giacomo-zanichelli/esp32_dev_board/esp32_dev_board.kicad_pcb

## KiCad design esp32_dev_board.kicad_pcb (2021-04-11)

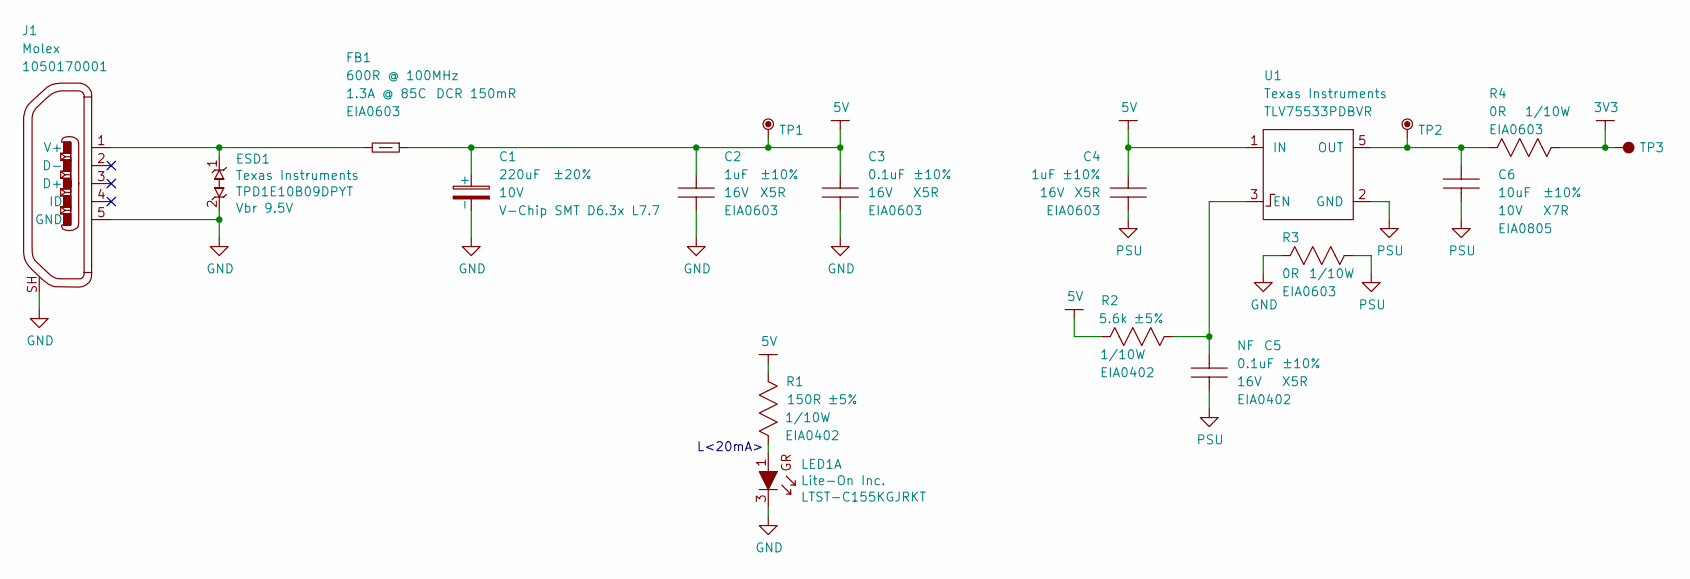
[picture p1: schematic psu.sch]

Parts:
C1: WE-865080245009; WE-86508xx450xx_CAPAE660X770D730L255X65N; Tolerance ±20%; Voltage 10V; MPN 865080245009
C2, C4: CAP-EIA0603; CAPC160X80X95L35N; Tolerance ±10%; Voltage 16V; MPN C0603C105K4PACTU
C3: CAP-EIA0603; CAPC160X80X95L35N; Tolerance ±10%; Voltage 16V; MPN C0603C104K4PACTU
C5: CAP-EIA0402; CAPC100X50X55L30N; Tolerance ±10%; Voltage 16V; MPN C0402C104K4PACTU
C6: CAP-EIA0805; CAPC200X125X110L50N; Tolerance ±10%; Voltage 10V; MPN C0805C106K8RACTU
ESD1: TI-TPD1E10B09DPYT; TI-TPD1E10B09DPYT_DIODFN2_100X60X45L25X50N; Breakdown Voltage Vbr 9.5V; MPN TPD1E10B09DPYT
FB1: FB-EIA0603; BEADC160X80X95L40N; MPN BLM18KG601SN1D
J1: Molex-1050170001; MPN 1050170001
LED1: LiteOn-LTST-C155KGJRKT; LiteOn-LTST-C155_LEDCAV4P138_270X320X110L50X90N; MPN LTST-C155KGJRKT
R1: RES-EIA0402; RESC100X50X40L25NN; Tolerance ±5%; Voltage N/A; MPN ERJ2GEJ151X
R2: RES-EIA0402; RESC100X50X40L25NN; Tolerance ±5%; Voltage N/A; MPN ERJ2GEJ562X
R3, R4: RES-EIA0603; RESC160X85X55L30N; Tolerance N/A; Voltage N/A; MPN ERJ3GEY0R00V
TP1, TP2: Test-Point-THT; TestPoint-THT_C150H100
TP3: Test-Point-SMT; TestPoint-SMT_C100
U1: TI-TLV75533PDBVR; TI-TLV755_SOT23-5P95_280X145L45X40N; MPN TLV75533PDBVR

Connections:
3V3: R4.2, TP3.1; also elsewhere on the board
5V: C1.1 (+), C2.1, C3.1, C4.1, FB1.2, R1.2, R2.2, TP1.1, U1.1 (IN)
GND: C1.2 (-), C2.2, C3.2, ESD1.2, J1.5 (GND), J1.SH, LED1.3 (C), R3.1; also elsewhere on the board
unnamed: C5.1, R2.1, U1.3 (EN)
unnamed: C6.1, R4.1, TP2.1, U1.5 (OUT)
unnamed: ESD1.1, FB1.1, J1.1 (V+)
unnamed: LED1.1 (A), R1.1
PSU: C4.2, C5.2, C6.2, R3.2, U1.2 (GND)

Notes on the sheet:
L<20mA>

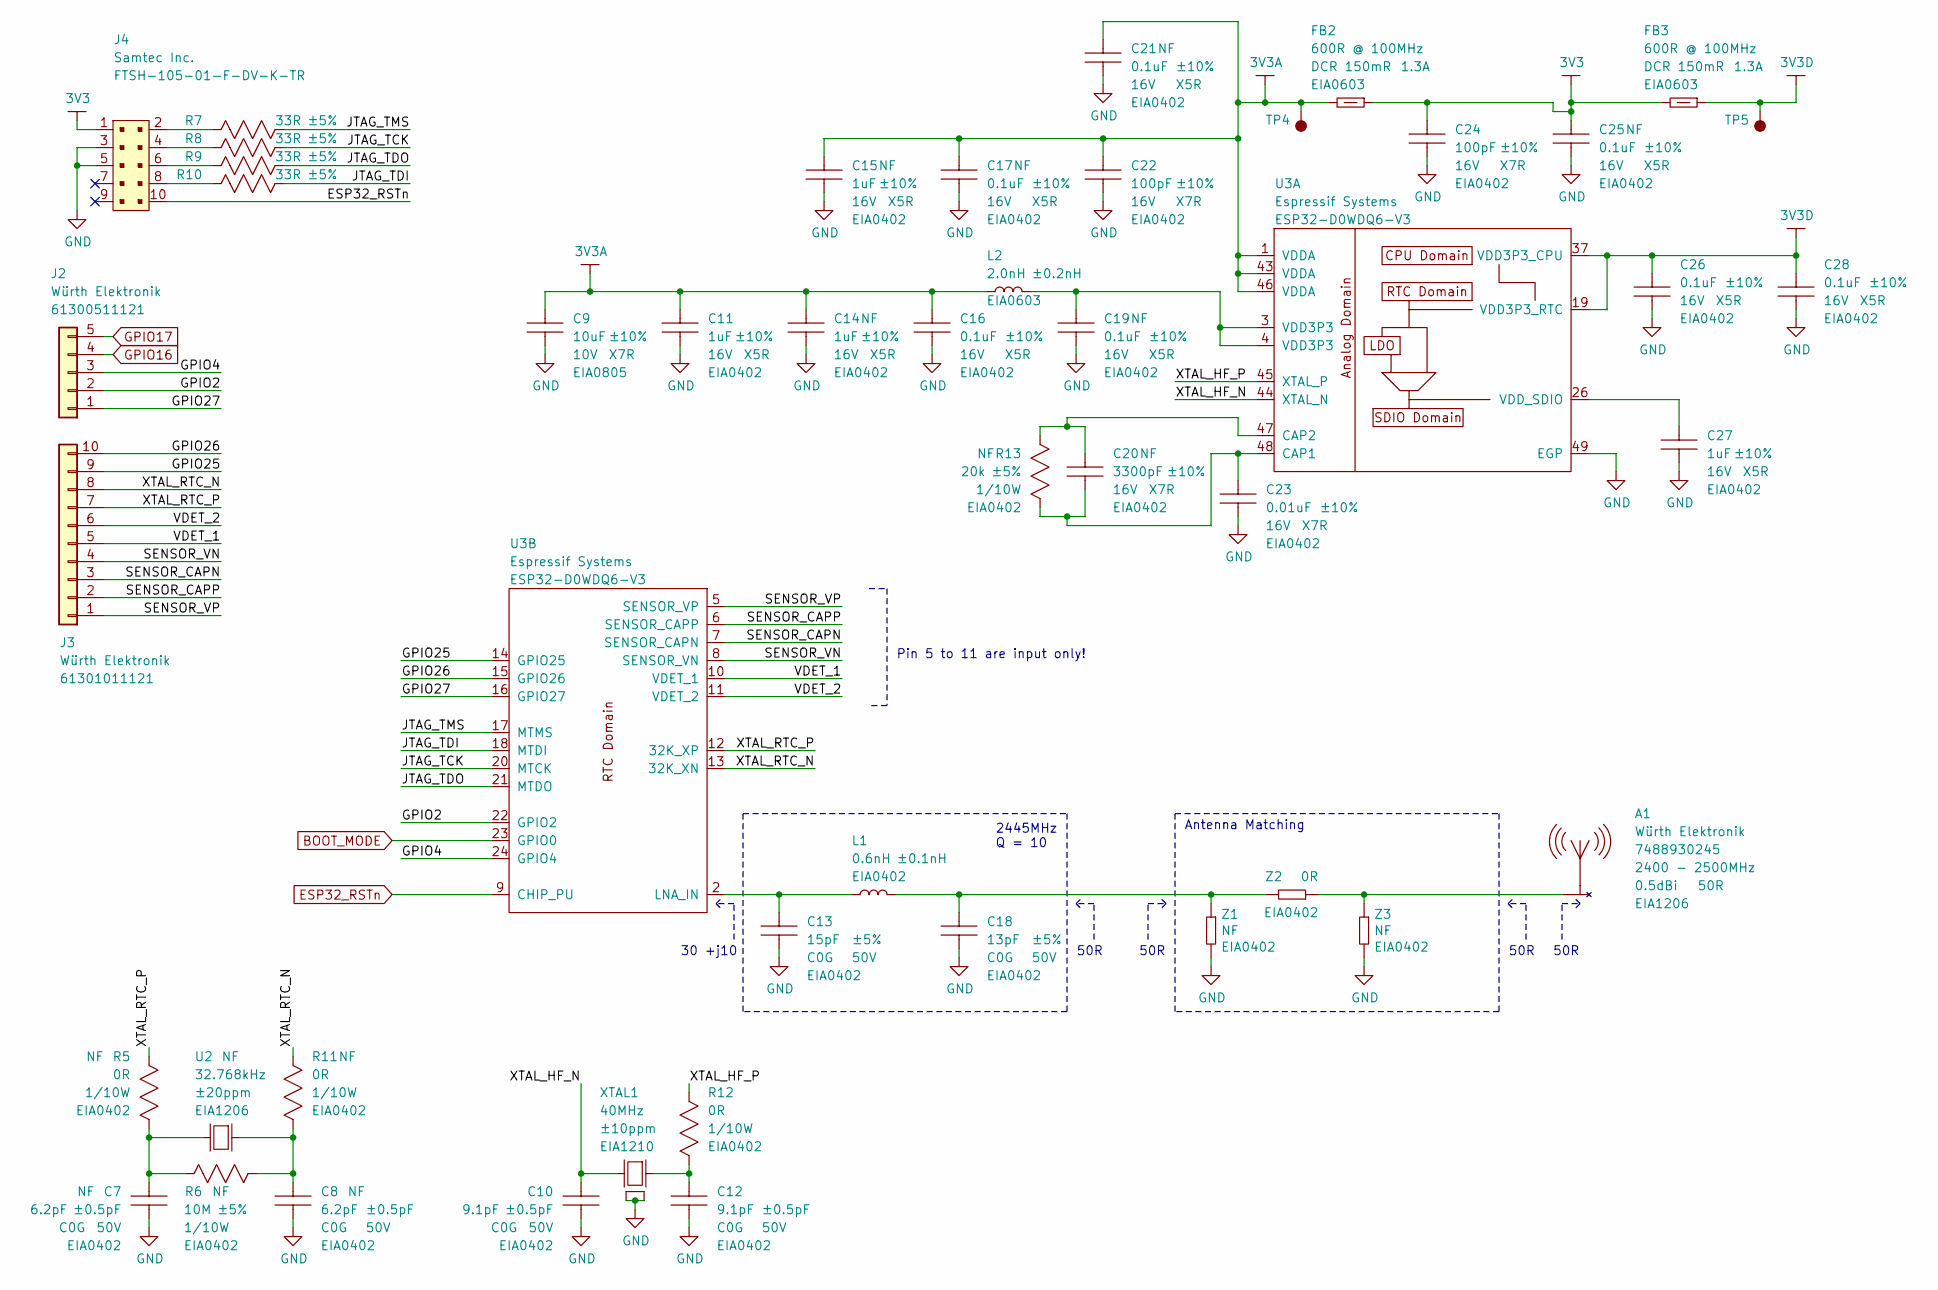
[picture p2: schematic mcu.sch]

Parts:
A1: WE-7488930245; WE-7488930245_ANTC320X160X140L50N; MPN 7488930245
C7, C8, C10, C12: CAP-EIA0402; CAPC100X50X55L30N; Tolerance ±0.5pF; Voltage 50V; MPN C0402C919D5GACTU
C9: CAP-EIA0805; CAPC200X125X110L50N; Tolerance ±10%; Voltage 10V; MPN C0805C106K8RACTU
C11, C14, C15, C27: CAP-EIA0402; CAPC100X50X55L30N; Tolerance ±10%; Voltage 16V; MPN C0402C105K4PACTU
C13: CAP-EIA0402; CAPC100X50X55L30N; Tolerance ±5%; Voltage 50V; MPN C0402C150J5GACTU
C16, C17, C19, C21, C25, C26, C28: CAP-EIA0402; CAPC100X50X55L30N; Tolerance ±10%; Voltage 16V; MPN C0402C104K4PACTU
C18: CAP-EIA0402; CAPC100X50X55L30N; Tolerance ±5%; Voltage 50V; MPN C0402C130J5GACTU
C20: CAP-EIA0402; CAPC100X50X55L30N; Tolerance ±10%; Voltage 16V; MPN C0402C332K4RACTU
C22, C24: CAP-EIA0402; CAPC100X50X55L30N; Tolerance ±10%; Voltage 16V; MPN C0402C101K4RACTU
C23: CAP-EIA0402; CAPC100X50X55L30N; Tolerance ±10%; Voltage 16V; MPN C0402C103K4RACTU
FB2, FB3: FB-EIA0603; BEADC160X80X95L40N; MPN BLM18KG601SN1#
J2: WE-61300511121; WE-61300511121_HDRV5W79P254_5X1_1270X254H854; MPN 61300511121
J3: WE-61301011121; WE-61301011121_HDRV10W64P254_10X1_2540X254X884N; MPN 61301011121
J4: Samtec-FTSH-105-01-F-DV-K-TR; Samtec_FTSH-105-01-F-DV-K-TR; MPN FTSH-105-01-F-DV-K-TR
L1: IND-EIA0402; INDC100X50X55L25N; Tolerance ±0.1nH; MPN MLG1005S0N6BT000
L2: IND-EIA0603; INDC160X80X95L40N; Tolerance ±0.2nH; MPN LQP03HQ2N0C02D
R5, R11, R12: RES-EIA0402; RESC100X50X40L25NN; Tolerance N/A; Voltage N/A; MPN ERJ2GE0R00X
R6: RES-EIA0402; RESC100X50X40L25NN; Tolerance ±5%; Voltage N/A; MPN ERJ2GEJ106X
R7, R8, R9, R10: RES-EIA0402; RESC100X50X40L25NN; Tolerance ±5%; Voltage N/A; MPN ERJ2GEJ330X
R13: RES-EIA0402; RESC100X50X40L25NN; Tolerance ±5%; Voltage N/A; MPN ERJ2GEJ203X
TP4, TP5: Test-Point-SMT; TestPoint-SMT_C100
U2: RaltronElectronics-RT3215-32.768-6-TR; RaltronElectronics-RT3215_XTALDFN2_320X150X90L65X130N; Tolerance ±20ppm; MPN RT3215-32.768-6-TR
U3: Espressif_ESP32-D0WDQ6-V3; Espressif-ESP32_QFN49P40_600X600X90L40X20T430N; MPN ESP32-D0WDQ6-V3
XTAL1: RaltronElectronics-RH100-40.000-9-F-1010-EXT-TR; RaltronElectronics-RH100_XTALDFN4_250X320X80L90X100N; Tolerance ±10ppm; MPN RH100-40.000-9-F-1010-EXT-TR
Z1, Z2, Z3: Z-EIA0402; RESC100X50X40L25NN; Tolerance TBD; MPN TBD

Connections:
3V3: C24.1, C25.1, FB2.2, FB3.1, J4.1; also elsewhere on the board
3V3A: C9.1, C11.1, C14.1, C15.1, C16.1, C17.1, C21.1, C22.1, FB2.1, L2.1, TP4.1, U3.1 (VDDA), U3.43 (VDDA), U3.46 (VDDA)
3V3D: C26.1, C28.1, FB3.2, TP5.1, U3.19 (VDD3P3_RTC), U3.37 (VDD3P3_CPU)
/MCU/GPIO2: J2.2, U3.22 (GPIO2)
/MCU/GPIO4: J2.3, U3.24 (GPIO4)
/MCU/GPIO25: J3.9, U3.14 (GPIO25)
/MCU/GPIO26: J3.10, U3.15 (GPIO26)
/MCU/GPIO27: J2.1, U3.16 (GPIO27)
/MCU/JTAG_TCK: R8.1, U3.20 (MTCK)
/MCU/JTAG_TDI: R10.1, U3.18 (MTDI)
/MCU/JTAG_TDO: R9.1, U3.21 (MTDO)
/MCU/JTAG_TMS: R7.1, U3.17 (MTMS)
/MCU/SENSOR_CAPN: J3.3, U3.7 (SENSOR_CAPN)
/MCU/SENSOR_CAPP: J3.2, U3.6 (SENSOR_CAPP)
/MCU/SENSOR_VN: J3.4, U3.8 (SENSOR_VN)
/MCU/SENSOR_VP: J3.1, U3.5 (SENSOR_VP)
/MCU/VDET_1: J3.5, U3.10 (VDET_1)
/MCU/VDET_2: J3.6, U3.11 (VDET_2)
/MCU/XTAL_HF_N: C10.1, U3.44 (XTAL_N), XTAL1.1
/MCU/XTAL_HF_P: R12.1, U3.45 (XTAL_P)
/MCU/XTAL_RTC_N: J3.8, R11.1, U3.13 (32K_XN)
/MCU/XTAL_RTC_P: J3.7, R5.1, U3.12 (32K_XP)
BOOT_MODE: U3.23 (GPIO0); also elsewhere on the board
ESP32_RSTn: J4.10, U3.9 (CHIP_PU); also elsewhere on the board
GND: C7.2, C8.2, C9.2, C10.2, C11.2, C12.2, C13.2, C14.2, C15.2, C16.2, C17.2, C18.2, C19.2, C21.2, C22.2, C23.2, C24.2, C25.2, C26.2, C27.2, C28.2, J4.3, J4.5, U3.49 (EGP), XTAL1.2, XTAL1.4, Z1.2, Z3.2; also elsewhere on the board
GPIO16: J2.4; also elsewhere on the board
GPIO17: J2.5; also elsewhere on the board
unnamed: A1.1, Z2.1, Z3.1
unnamed: C7.1, R5.2, R6.2, U2.1
unnamed: C8.1, R6.1, R11.2, U2.2
unnamed: C12.1, R12.2, XTAL1.3
unnamed: C13.1, L1.1, U3.2 (LNA_IN)
unnamed: C18.1, L1.2, Z1.1, Z2.2
unnamed: C19.1, L2.2, U3.3 (VDD3P3), U3.4 (VDD3P3)
unnamed: C20.1, C23.1, R13.1, U3.48 (CAP1)
unnamed: C20.2, R13.2, U3.47 (CAP2)
unnamed: C27.1, U3.26 (VDD_SDIO)
unnamed: J4.2, R7.2
unnamed: J4.4, R8.2
unnamed: J4.6, R9.2
unnamed: J4.8, R10.2

Notes on the sheet:
30 +j10
50R
2445MHz Q = 10
Antenna Matching
Pin 5 to 11 are input only!

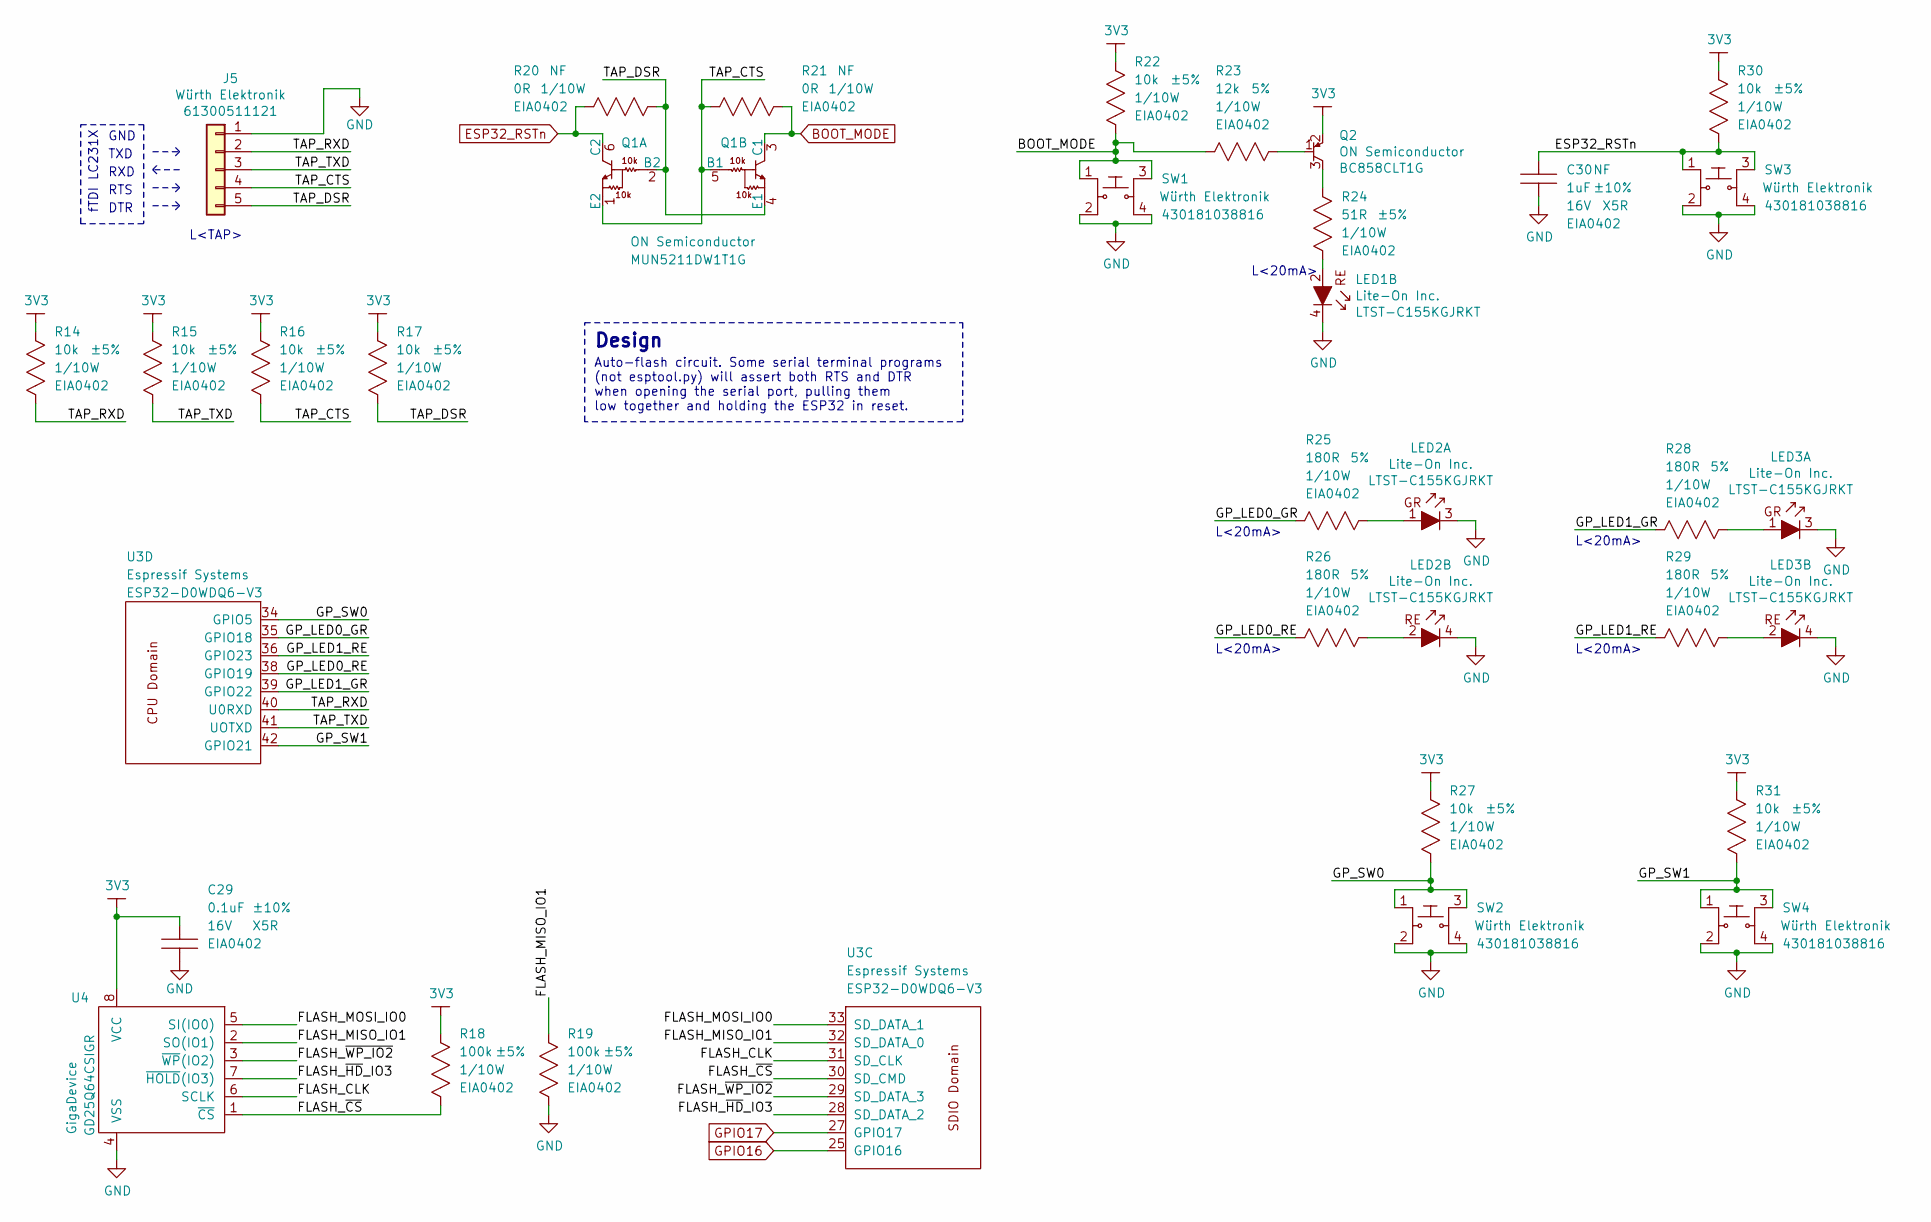
[picture p3: schematic mcu_io.sch]

Parts:
C29: CAP-EIA0402; CAPC100X50X55L30N; Tolerance ±10%; Voltage 16V; MPN C0402C104K4PACTU
C30: CAP-EIA0402; CAPC100X50X55L30N; Tolerance ±10%; Voltage 16V; MPN C0402C105K4PACTU
J5: WE-61300511121; WE-61300511121_HDRV5W79P254_5X1_1270X254H854; MPN 61300511121
LED1, LED2, LED3: LiteOn-LTST-C155KGJRKT; LiteOn-LTST-C155_LEDCAV4P138_270X320X110L50X90N; MPN LTST-C155KGJRKT
Q1: ON-Semi_MUN5211DW1T1G; ON-Semi-MUN5211DW1T1G_SOT23-6P65_210X110L36X20L; MPN MUN5211DW1T1G
Q2: ON-Semi_BC858CLT1G; ON-Semi-BC858CLT1G_SOT23-3P85_237X111L42X43N; MPN BC858CLT1G
R14, R15, R16, R17, R22, R27, R30, R31: RES-EIA0402; RESC100X50X40L25NN; Tolerance ±5%; Voltage N/A; MPN ERJ2GEJ103X
R18, R19: RES-EIA0402; RESC100X50X40L25NN; Tolerance ±5%; Voltage N/A; MPN ERJ-2GEJ104X
R20, R21: RES-EIA0402; RESC100X50X40L25NN; Tolerance N/A; Voltage N/A; MPN ERJ2GE0R00X
R23: RES-EIA0402; RESC100X50X40L25NN; Tolerance 5%; Voltage N/A; MPN ERJ2GEJ123X
R24: RES-EIA0402; RESC100X50X40L25NN; Tolerance ±5%; Voltage N/A; MPN ERJ2GEJ510X
R25, R26, R28, R29: RES-EIA0402; RESC100X50X40L25NN; Tolerance 5%; Voltage N/A; MPN ERJ2GEJ181X
SW1, SW2, SW3, SW4: WE-430181038816; WE-430181038816_SWSOFL4P150_450X750X380L150X70N; MPN 430181038816
U3: Espressif_ESP32-D0WDQ6-V3; Espressif-ESP32_QFN49P40_600X600X90L40X20T430N; MPN ESP32-D0WDQ6-V3
U4: GigaDevice-GD25Q64CSIGR; GigaDevice-GD25Q64CS_SOIC8P127_523X790X216L67X41N; MPN GD25Q64CSIGR

Connections:
3V3: C29.1, Q2.2 (E), R14.1, R15.1, R16.1, R17.1, R18.1, R22.1, R27.1, R30.1, R31.1, U4.8 (VCC); also elsewhere on the board
/MCU_IO/FLASH_CLK: U3.31 (SD_CLK), U4.6 (SCLK)
/MCU_IO/FLASH_MISO_IO1: R19.1, U3.32 (SD_DATA_0), U4.2 (SO(IO1))
/MCU_IO/FLASH_MOSI_IO0: U3.33 (SD_DATA_1), U4.5 (SI(IO0))
/MCU_IO/FLASH_~CS~: R18.2, U3.30 (SD_CMD), U4.1 (~CS)
/MCU_IO/FLASH_~HD~_IO3: U3.28 (SD_DATA_2), U4.7 (~HOLD~(IO3))
/MCU_IO/FLASH_~WP_IO2: U3.29 (SD_DATA_3), U4.3 (~WP~(IO2))
/MCU_IO/GP_LED0_GR: R25.1, U3.35 (GPIO18)
/MCU_IO/GP_LED0_RE: R26.1, U3.38 (GPIO19)
/MCU_IO/GP_LED1_GR: R28.1, U3.39 (GPIO22)
/MCU_IO/GP_LED1_RE: R29.1, U3.36 (GPIO23)
/MCU_IO/GP_SW0: R27.2, SW2.1, SW2.3, U3.34 (GPIO5)
/MCU_IO/GP_SW1: R31.2, SW4.1, SW4.3, U3.42 (GPIO21)
/MCU_IO/TAP_CTS: J5.4, Q1.1 (E2), Q1.5 (B1), R16.2, R21.1
/MCU_IO/TAP_DSR: J5.5, Q1.2 (B2), Q1.4 (E1), R17.2, R20.2
/MCU_IO/TAP_RXD: J5.2, R14.2, U3.40 (U0RXD)
/MCU_IO/TAP_TXD: J5.3, R15.2, U3.41 (UOTXD)
BOOT_MODE: Q1.3 (C1), R21.2, R22.2, R23.1, SW1.1, SW1.3; also elsewhere on the board
ESP32_RSTn: C30.1, Q1.6 (C2), R20.1, R30.2, SW3.1, SW3.3; also elsewhere on the board
GND: C29.2, C30.2, J5.1, LED1.4 (C), LED2.3 (C), LED2.4 (C), LED3.3 (C), LED3.4 (C), R19.2, SW1.2, SW1.4, SW2.2, SW2.4, SW3.2, SW3.4, SW4.2, SW4.4, U4.4 (VSS); also elsewhere on the board
GPIO16: U3.25 (GPIO16); also elsewhere on the board
GPIO17: U3.27 (GPIO17); also elsewhere on the board
unnamed: LED1.2 (A), R24.2
unnamed: LED2.1 (A), R25.2
unnamed: LED2.2 (A), R26.2
unnamed: LED3.1 (A), R28.2
unnamed: LED3.2 (A), R29.2
unnamed: Q2.1 (B), R23.2
unnamed: Q2.3 (C), R24.1

Notes on the sheet:
TXD
RXD
RTS
DTR
GND
fTDI LC231X
Design
Auto-flash circuit. Some serial terminal programs (not esptool.py) will assert both RTS and DTR when opening the serial port, pulling them low together and holding the ESP32 in reset.
L<TAP>
L<20mA>

Board: 4 copper layers, 95 parts (0 on the bottom side), 70 nets, no tracks yet.
