giacomo-zanichelli/esp32_dev_board/(commit log)

2021-02-28 Initialize project esp32_dev_board
2021-03-06 Add ESD protection to USB
    [psu.sch]
2021-03-06 Add FB to power input
    [psu.sch]
2021-03-06 Add e-cap on power rail
    [psu.sch]
2021-03-06 Add 1uF cap to power rail
    [psu.sch]
2021-03-06 Add 0.1uF cap to power rail
    [psu.sch]
2021-03-06 Add TI-TLV75533PDBVR.
    [psu.sch]
2021-03-08 Add LDO output cap.
    [psu.sch]
2021-03-08 Add PSU to GND jumper.
    [psu.sch]
2021-03-08 Add filter cap to LDO EN pin.
    [psu.sch]
2021-03-08 Add PU to LDO EN line.
    [psu.sch]
2021-03-08 Add 3V3 label to LDO output.
    [psu.sch]
2021-03-08 Add 0R jumper to LDO output and move 3V3 label after it.
    [psu.sch]
2021-03-08 Update ceramic capacitors with Vendor, Vendor_Pn, Fit fields following master library update.
    [psu.sch]
2021-03-08 Update symbols in psu.sch with Vendor, Vendor_PN, Fit fields.
    [mcu.sch, psu.sch]
2021-03-08 Update ESP32, GigaDevice GD25Q64 with Vendor, Vendor_PN, Fit fields from library.
    [mcu.sch]
2021-03-08 Update footprint ref in Molex USB connector.
    [psu.sch]
2021-03-08 Update footprint ref to footprint and footprint_generic library names.
    [mcu.sch]
2021-03-08 Update GigaDevice GD25Q64 value.
    [mcu.sch]
2021-03-08 Update GigaDevice-GD25Q64CSIGR datasheet ref.
    [mcu.sch]
2021-03-08 Update schematic to KEMET and Panasonic passives.
    [mcu.sch, psu.sch]
2021-03-09 Add Test points to PSU section.
    [psu.sch]
2021-03-09 Add VDD3P3 pins decoupling and HF harmonics filter.
    [mcu.sch]
2021-03-09 Sync repo, no change.
    [mcu.sch]
2021-03-10 Conclude PSU section of ESP32.
    [mcu.sch]
2021-03-10 Add ESP32 reset line R.
    [mcu.sch]
2021-03-10 Add ESP32 reset line C and label.
    [mcu.sch]
2021-03-10 Add reset tact switch circuit.
    [mcu.sch]
2021-03-10 Add HF XTAL circuit.
    [mcu.sch]
2021-03-10 Add RTC crystal circuit.
    [mcu.sch]
2021-03-10 Add external capacitor circuit to ESP32 section.
    [mcu.sch]
2021-03-10 Sync repo, no changes.
    [mcu.sch]
2021-03-11 Add harmonic filter to ESP32 RF front end.
    [mcu.sch]
2021-03-13 Add antenna matching section.
    [mcu.sch]
2021-03-13 Separate MCU I/O sections in their own sheet.
    [esp32_dev_board.sch, mcu.sch, mcu_io.sch, psu.sch]
2021-03-13 Add BOOT_MODE tact switch.
    [mcu.sch]
2021-03-13 Add power and boot mode LED's.
    [mcu.sch, mcu_io.sch, psu.sch]
2021-03-14 Add TAP interface.
    [mcu_io.sch]
2021-03-15 Add flow control to TAP to auto-flash ESP32.
    [mcu_io.sch]
2021-03-15 Add auto-flash circuit to prevent DTR == 1 && RTS == 1 condition to keep ESP32 in reset.
    [mcu.sch, mcu_io.sch]
2021-03-15 Add TAP pull-ups; NF R to bypass auto-flash NPN network.
    [mcu_io.sch]
2021-03-21 Add TAP layout note; move ESP32 boot mode and reset button to I/O sheet.
    [mcu_io.sch]
2021-03-21 Fix Boot Mode LED circuit (add PNP drive); add 2x BiColour general-purpose LED's.
    [mcu.sch, mcu_io.sch]
2021-03-21 Add current requirement to Power On LED.
    [psu.sch]
2021-03-21 Add general purpose tact switches.
    [mcu_io.sch]
2021-03-21 Add JTAG interface.
    [mcu.sch]
2021-03-28 Bring out on headers all unused ESP32 pins.
    [mcu.sch, mcu_io.sch]
2021-03-28 Add antenna.
    [mcu.sch]
2021-03-28 Annotate schematic.
    [mcu.sch, mcu_io.sch, psu.sch]
2021-03-28 Start layout config.
    [esp32_dev_board.kicad_pcb]
2021-04-11 Start layout.
    [esp32_dev_board.kicad_pcb, esp32_dev_board.sch, mcu.sch, mcu_io.sch, psu.sch]
2021-04-11 Fix wrong footprint on GigaDevice part (correct in library though).
    [esp32_dev_board.kicad_pcb, esp32_dev_board.sch, mcu.sch, mcu_io.sch, psu.sch]
2021-04-11 Update J4 footprint after removing leading zeros in pad names.
    [esp32_dev_board.kicad_pcb]
2021-04-11 Annotate test points.
    [mcu.sch, psu.sch]
2021-04-11 Update power symbols after change to pin names; annotate.
    [esp32_dev_board.kicad_pcb, mcu.sch, mcu_io.sch, psu.sch]
2021-04-11 Mid-way through placement.
    [esp32_dev_board.kicad_pcb]
2021-04-11 Update placement.
    [esp32_dev_board.kicad_pcb, mcu.sch]
